Picatout/metal_detector/schematic.pdf

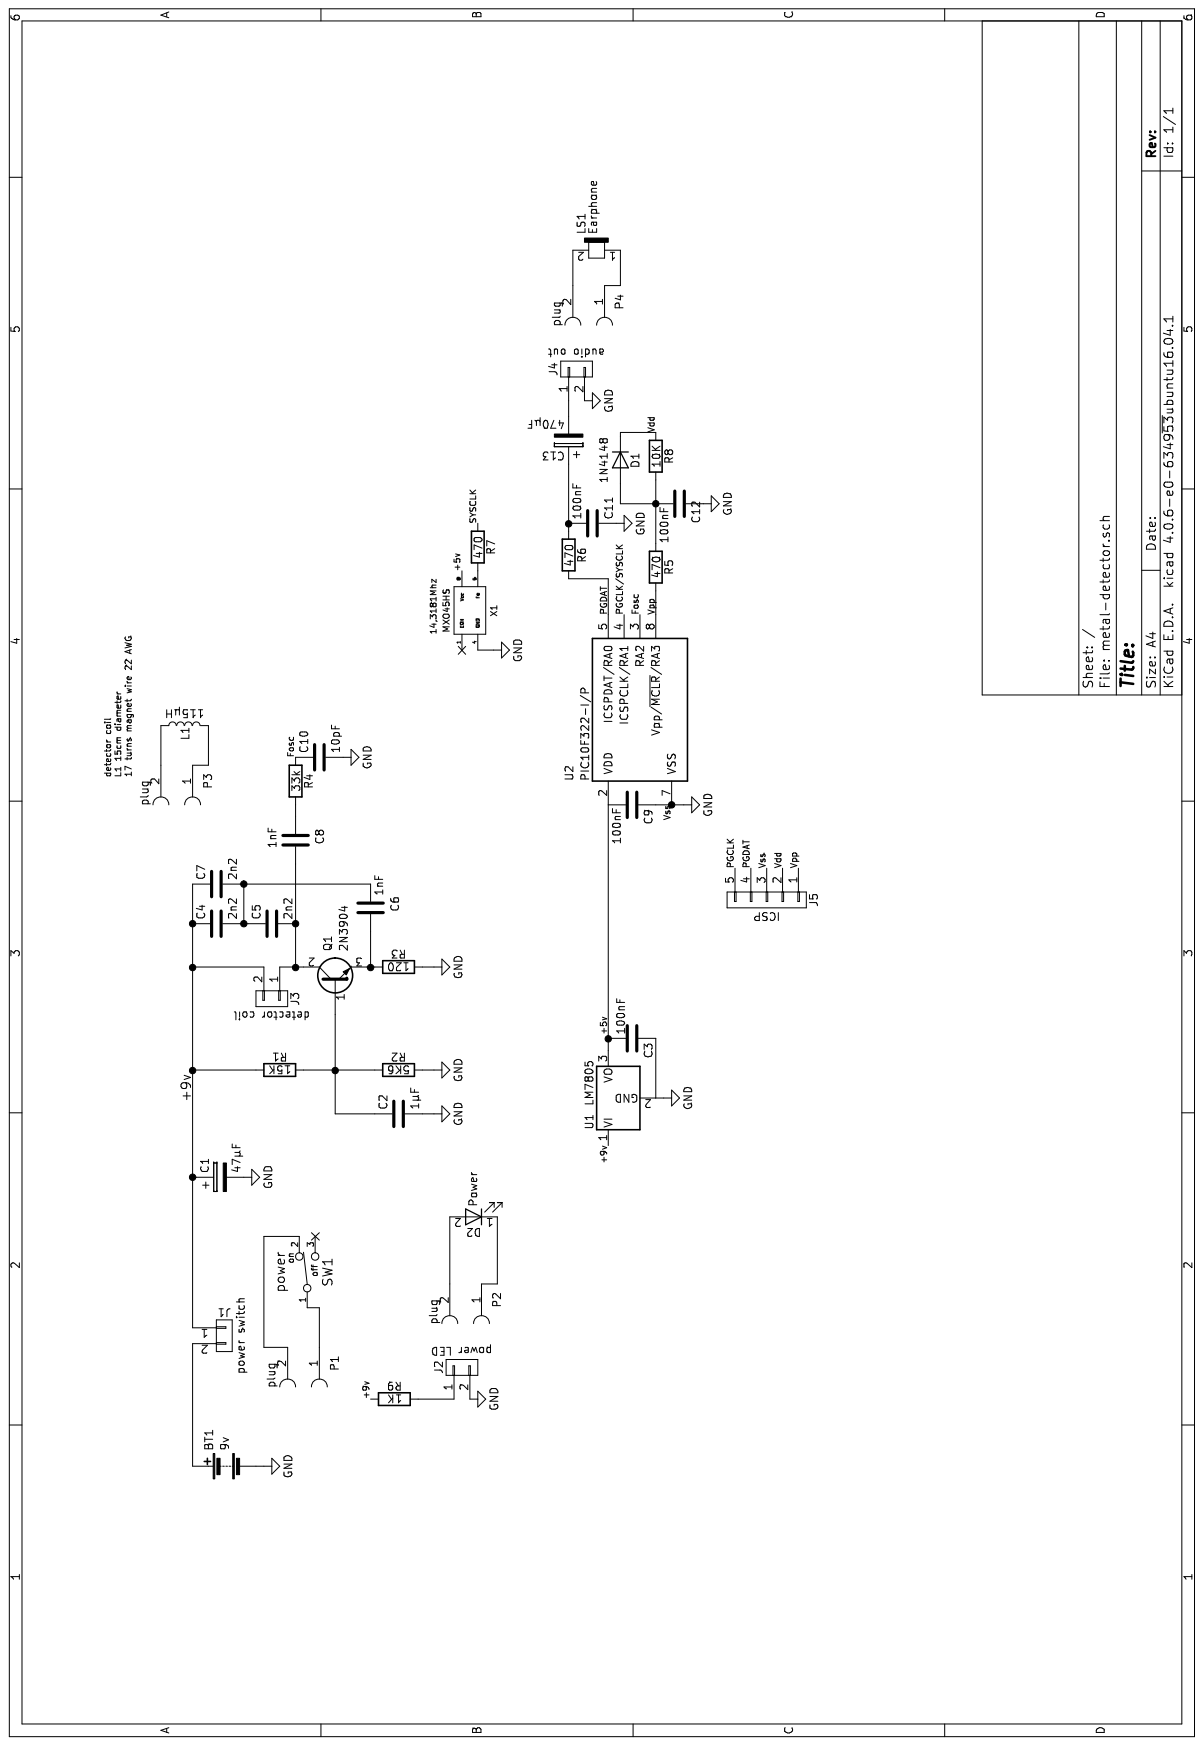
[picture p4: page 1]
