Picatout/metal_detector/KiCAD/metal-detector.kicad_pcb

## KiCad design ESP8266_arduino.sch

Schematic: ESP8266_arduino.sch

Parts:
R1: 10k
R2: 1K
SW1: SW_Push
U1: ESP-12E
