Picatout/metal_detector/KiCAD/metal-detector.kicad_pcb

## KiCad design regulation.sch

Schematic: regulation.sch

Parts:
C1, C2: 10uF
R3: 10k
U2: MIC5524; DFN-4
